AhnYeonjo/MEGAKEY_GITHUB/(commit log)

2026-10-11 MegaKey firmware collection: AVR128DB64 / Pro Micro / RP2040 (GP2040-CE)
    Reorganized Arduino & RP2040 firmware into a single repository.
    - firmware/MegaKey_AVR128DB64 : main board v4.0 (+ bundled jvsio lib)
    - firmware/MegaKey_IO : previous-gen Pro Micro JVS IO
    - firmware/MultiSourceController
    - firmware/PowerController
    - firmware/IR_SignalAnalyzer
    - rp2040/addons : GP2040-CE Serial Input Addon v2.4
    - rp2040/firmware/BoardConfig.h: Waveshare RP2040-Zero pinmap
    - docs/ : circuit diagram & pinmap HTML
2026-10-11 docs: translate all in-repo comments and diagrams to English
    - Rewrite README.md and the two docs/ HTML diagrams in polished English
    (circuit/BOM/truth-table/pinmap prose cleaned up, lang=en, layout notes)
    - Translate Korean source comments to English across firmware/ and rp2040/
    (comments only — code, identifiers, string literals, pins unchanged)
    - gitignore note in English
2026-10-11 docs: add English module documentation with diagrams
    - ARCHITECTURE.md: whole-system composition, module map, wiring index,
    KVM truth table, protocol mode table, mermaid overview
    - rp2040-gp2040-addon.md: CompactMessage wire format (13-byte frame,
    CRC8 0x8C), 1P/2P split via PLAYER_NUMBER, mode-switch reboot,
    GP2040-CE build/flash + wiring, PS4 2P end-to-end example
    - per-sketch docs: MegaKey_AVR128DB64, MegaKey_IO, MultiSourceController,
    PowerController, IR_SignalAnalyzer (mermaid block diagrams included)
    - README: documentation index table
2026-10-11 docs: remove circuit diagram HTMLs (pin claims contradict firmware)
    The two diagrams mapped IR to Mega D46 and MUX control to A6-A9, but the
    firmware uses D3 (Mega v3.4) / PA2 (AVR v4.0) for IR and A10/A12/A14/A15
    (Mega) or 74HC595 bits 6-9 (AVR) for the USB mux — A7/A9 are actually the
    1P RB/LB button pins. Truth table and wiring facts are consolidated into
    docs/ARCHITECTURE.md instead.
2026-10-11 docs: recreate circuit documentation as Markdown
    - circuit-ir-usb-mux.md: IR driver (corrected pins D3/PA2), mux control
    per board generation (A10/A12/A14/A15 vs 74HC595 bits 6-9), corrected
    channel truth table, BOM, PCB layout rules
    - sn74cb3q3253-mux.md: chip control semantics verified in firmware;
    unverified physical pin numbers intentionally omitted with a note to
    check the TI datasheet (SCES560)
    - docs are now 100% Markdown; README/ARCHITECTURE indexes updated
2026-10-11 hardware: archive EasyEDA PCB exports mapped to firmware modules
    - MegaKey_IO v3.4 schematic PDF (MEGAPRO + 2x RP2040_ZERO footprints)
    - USB mux / HDMI selector sub-board schematic PDF
    - v4.0 AVR128DB64 netlist (.tel) + schematic sheet SVGs
    - MultiSourceController and PowerController schematic PDFs
    - hardware/README.md: firmware-PCB correspondence table, JLCPCB part numbers
    - root README: Hardware section linking hardware/
2026-10-11 hardware: add JLCPCB fabrication zips (MegaPCB/POWERPCB/USBMUX); fix USB mux chip SN74CB3Q3253 -> FSUSB42
    Verified the three EasyEDA/JLCPCB export zips against the firmware:
    - MegaPCB = MEGA2560-PRO + 2x RP2040 ZERO footprint, JAMMA1/2, JVSIO,
    DREAMCAST_1P/2P, MUX1/2 -> matches firmware/MegaKey_IO (v3.4).
    - POWERPCB = K1..K7 relays, IRLZ44N LED PWM MOSFET, 12V_PWN, JAMMA/12V ->
    matches firmware/PowerController (K1-K7 + PIN_LED_PWM).
    - USBMUX = refdes U1/U2 'FSUSB42MUX' + USB_HUB + AMS1117-3.3 + PC1..PC4 ->
    matches setKvmChannel() (MUX SEL + active-low OE).
    Chip correction: the mux is the TI FSUSB42 (USB 2.0 HS DPDT switch), not the
    SN74CB3Q3253 name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
2026-10-11 docs: README hardware section -> root JLCPCB zips (per-board firmware mapping + AVR128DB64 gap note)
2026-10-11 docs: move fab zips into hardware/ + README; add VEWLIX purpose and ATX-power role
    - hardware/ now holds MegaPCB/POWERPCB/USBMUX zips + hardware/README.md index.
    - README top: project developed to integrate many consoles through a single
    VEWLIX arcade cabinet.
    - PowerController = drives a standard ATX PSU as the cabinet main power,
    sequencing JAMMA/TTX3/Naomi/AC relay loads (README + module doc + hw README).
    - Verified: Korean 0, dead links 0.
